danimolsen1988/wifa_lock/README.md

# WiFa_Lock
The wifa_lock is an IoT device capable of opening a lock, using facial recognition.
The development of this device has been a part of a course at Aarhus University.
The participants are on the 5th semester of the Electronics engineering branch.

# Contributors
- Jakob Aaboe Vestergaard
- Nikolaj Just Morsing
- Dani Mølgaard Olsen

# How to
- The report can be found in "Report"-folder

- The source code can be found in "SourceCode"-folder

- Models and figures made during development, can be found in "Model_and_figures"-folder

- The artefacts created during the development, can be found in "Artefacts"-folder

- All the extras can be found in the "Appendix"-folder

- All the datasheets for components used in this project can be found in the "Datasheets"-folder

To get started - see the verification section for prerequisites!

## Rich picture
The rich picture is an early system overview.  
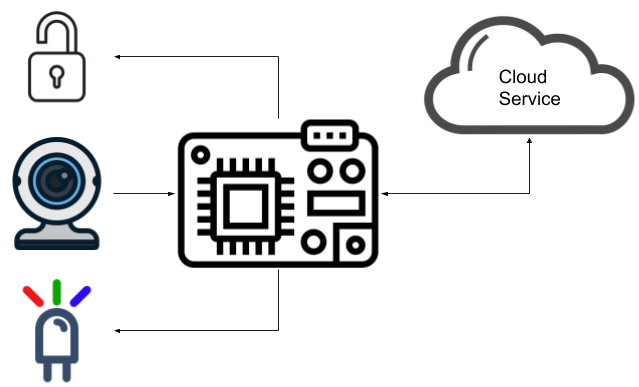
[picture p1: Models_and_figures/RichPicture.png]
GitHub Logo


## Prototype
### Main module
<p align="center">  
  
</p>

### Camera module

<p align="center">  
  
</p>
