danimolsen1988/wifa_lock/Appendix/Schematic_Simulering_RC-differentiator.pdf

## RC-differentiator design og simulering

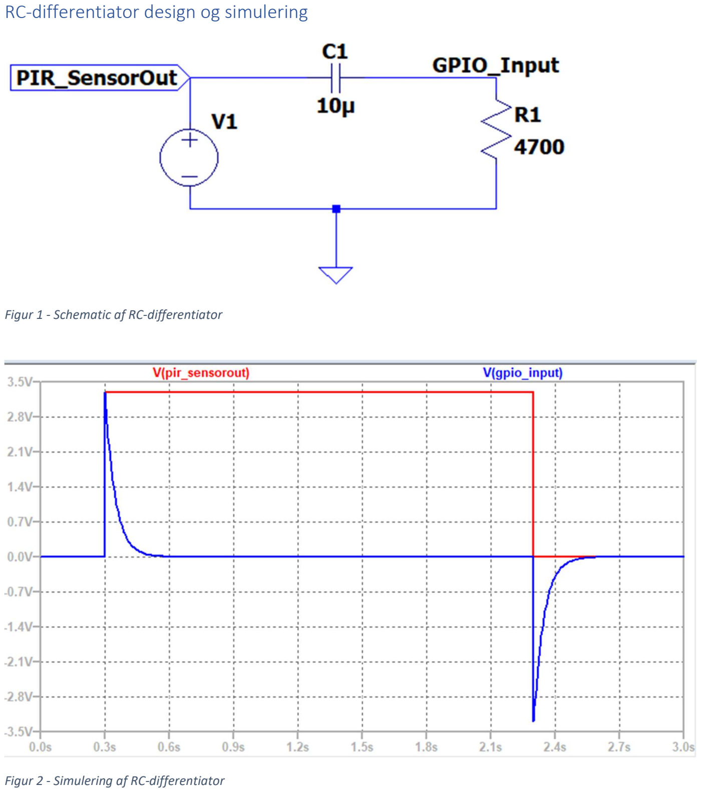
[picture p25: page 1]

Figur 1 - Schematic af RC-differentiator

Figur 2 - Simulering af RC-differentiator
