danimolsen1988/wifa_lock/Appendix/RC_og_Formodstand_udregninger.pdf

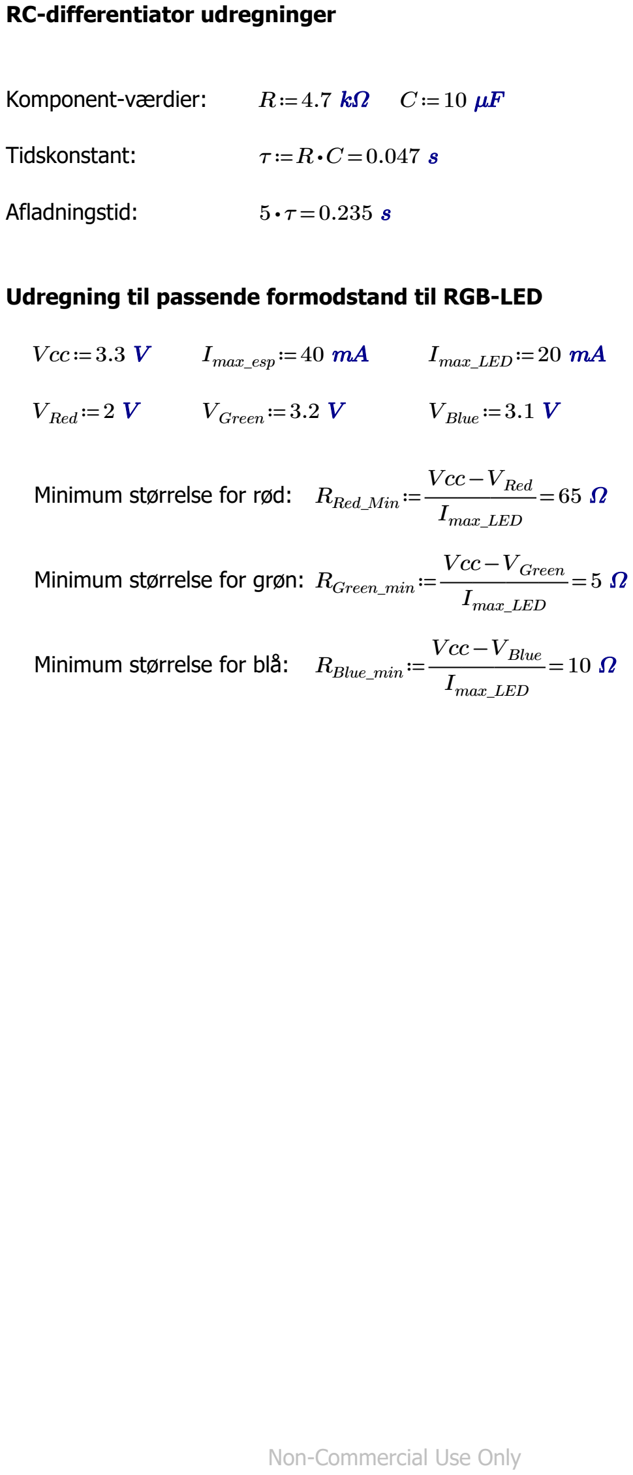
[picture p26: page 1]

RC-differentiator udregninger

Komponent-værdier: | R≔4.7 kΩ C≔10 μF
Tidskonstant: | τ≔R⋅C=0.047 s
Afladningstid: | 5 ⋅τ=0.235 s

Udregning til passende formodstand til RGB-LED

Vcc≔3.3 V | Imax_esp≔40 mA | Imax_LED≔20 mA
VRed≔2 V | VGreen≔3.2 V | VBlue≔3.1 V

Minimum størrelse for rød: RRed_Min≔――――=

| | Vcc-VRed Imax_LED 65 Ω

Minimum størrelse for grøn: RGreen_min≔――――=

| | Vcc-VGreen Imax_LED 5 Ω

Minimum størrelse for blå: RBlue_min≔――――=

| | Vcc-VBlue Imax_LED 10 Ω

Non-Commercial Use Only
