danimolsen1988/wifa_lock/Appendix/Hovedmodul_bilag.pdf

Hovedmodul
Her findes en mere dybdegående analyse af design af hovedmodelet
Hovedmodulets primære opgaver er at låse op for brugeren, hvis brugeren er i systemet. Derudover fungerer hovedmodulet som gateway imellem kameramodulet og Azure facial recognition service. På Figur 1 kan flowet af systemet ses.

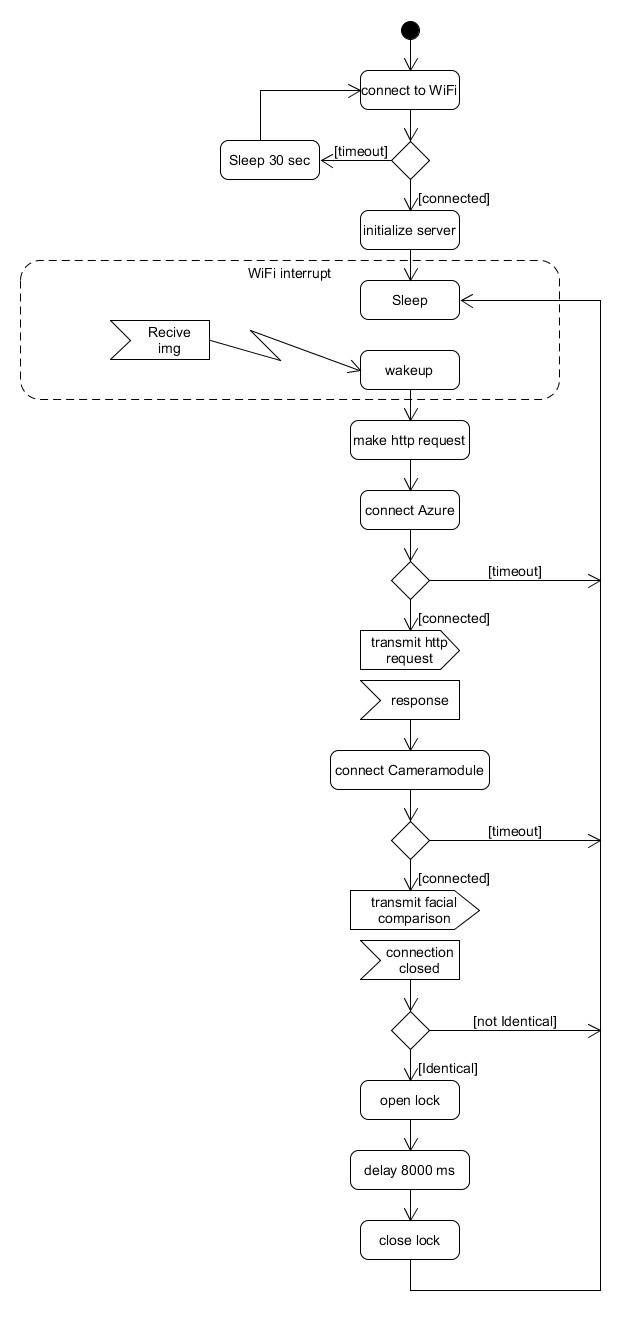
[picture p27: figure]

Figur 1 - aktivitetsdiagram over Hovedmodul

Figur 2 viser sekvensen over setup funktionen i arduio sketch filen. Denne funktion kører 1 gang som indledende setup, hvorefter funktionen loop sekventielt eksekveres i et loop. Sekvensdiagrammet for loop funktionen kan ses på Figur 3½

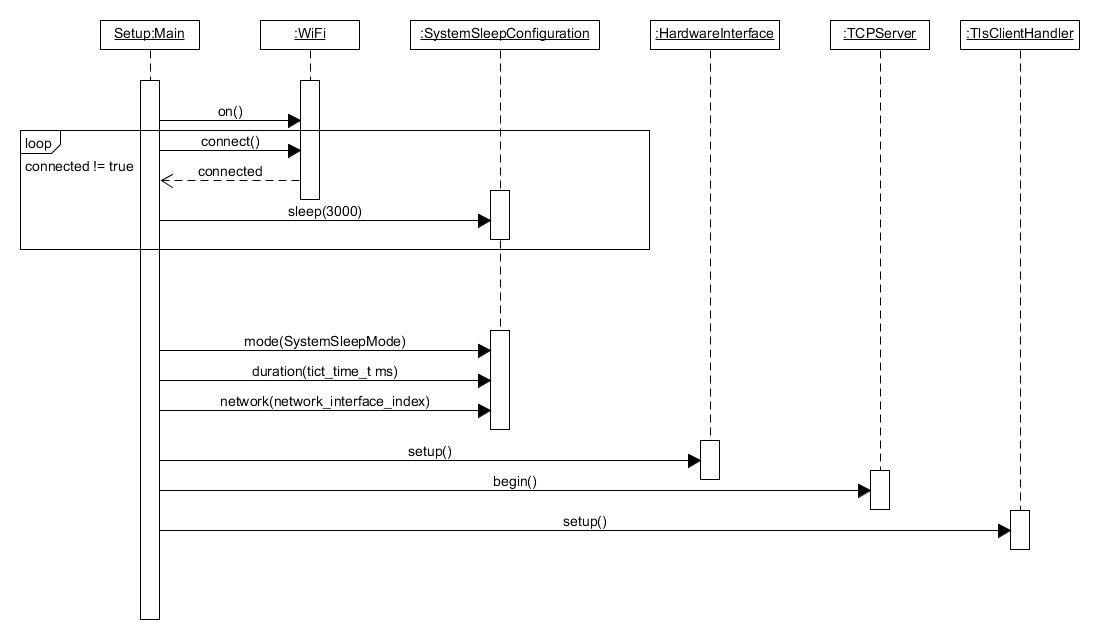
[picture p28: figure]

Figur 2 - sekvens diagram over setup i arduino sketch

Loop funktionen står for at styre mainflowet af programmet. Her ventes der på forbindelse TCP serveren der blev opretter i setup loopet. Når kameramodulet opretter forbindelse, modtages et billede der sendes over til TlsClientHandler klassen. Afhænging af retur værdien fra kaldet, sendes et svar tilbage til kameramodulet, indeholdende om personen blev godkendt eller ej. Blev Personen godkendt vil Servomotoren åbne i 8 sekunder, hvorefter den lukkes og system går i sleep tilstand

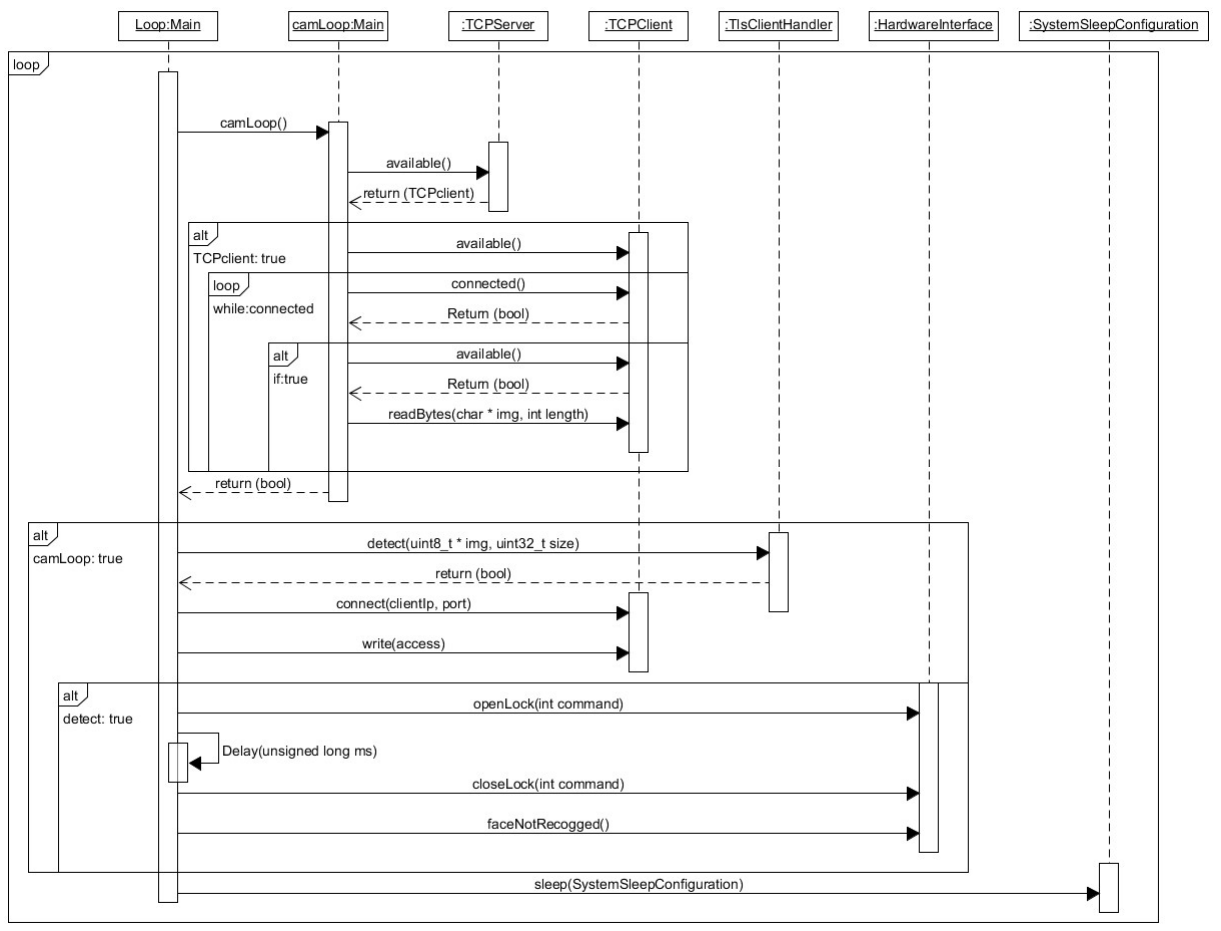
[picture p29: figure]

Figur 3 - sekvens diagram over loop i arduino sketch

Når detect bliver kaldt skal der forberedes til og sendes data til Azure, hvor der skal laves et http kald. Det er muligt og lave http kald vha. Particles cloud platform, men den understøtter ikke binary octet streams. Derfor er der designet en Httphelper klasse, der står for at parse http kald og svar. Forbindelsen til Azure oprettes via det eksterne bibliotek TlsTcpClient der er bygget op omkring mbedTLSOG Particles TCPClient. For at samle tls klienten med klassen HttpHelper er der designet en TlsClientHandler, der HttpHelper og kommunikationen imellem Azure.

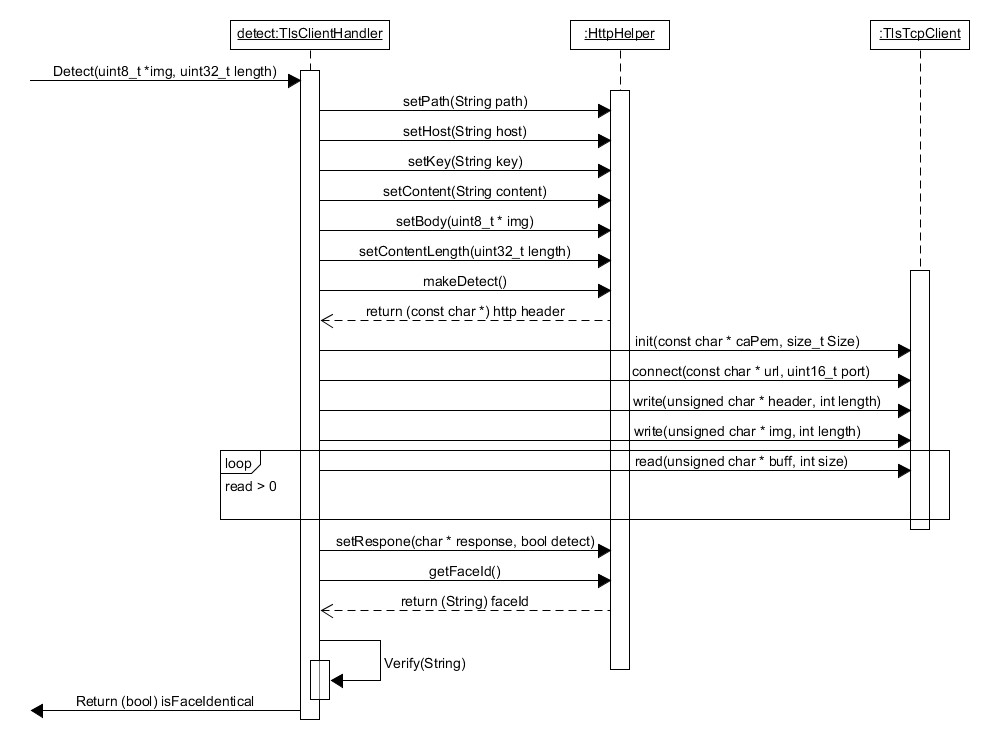
[picture p30: figure]

Figur 4 - sekvens diagram over detect
På Figur 4 kan det ses hvordan TlsClientHandler interagerer med de 2 klasser. For at sammenligne et ansigt skal Azure først detektere et ansigt, hvorefter der returneres et id. Dette id kan efterfølgende sendes til sammenligning med en person, allerede gemt i Azures database. Dette gøres med kaldet Verify, som kan ses på Figur 5.

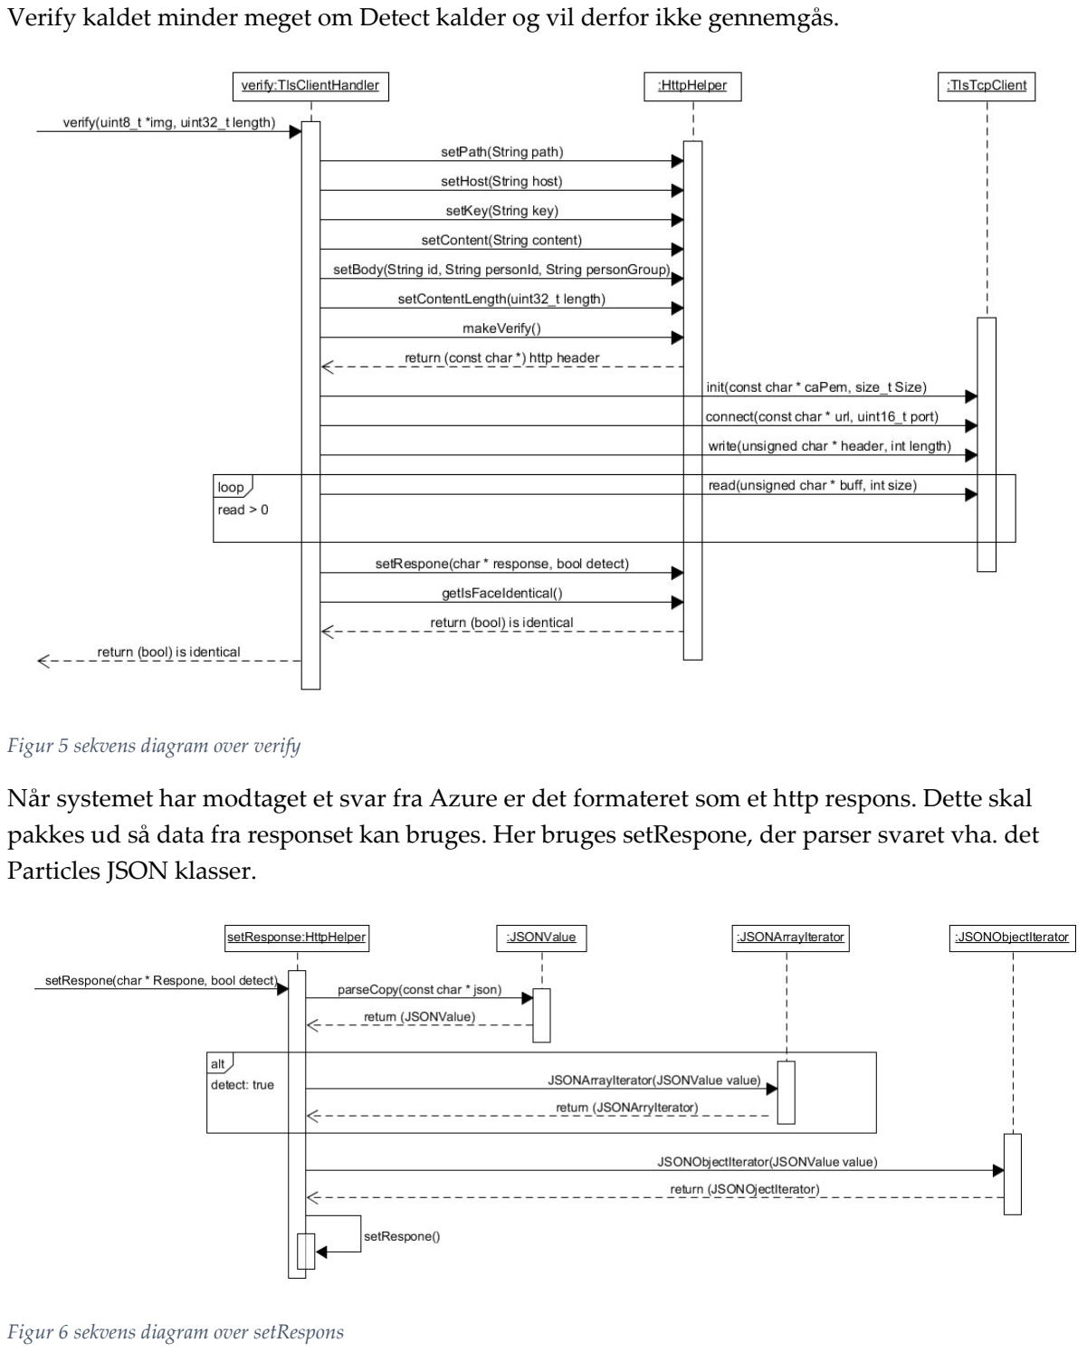
[picture p31: page 5]

Verify kaldet minder meget om Detect kalder og vil derfor ikke gennemgås.

Figur 5 sekvens diagram over verify
Når systemet har modtaget et svar fra Azure er det formateret som et http respons. Dette skal pakkes ud så data fra responset kan bruges. Her bruges setRespone, der parser svaret vha. det Particles JSON klasser.

Figur 6 sekvens diagram over setRespons

Dette giver nedenstående klassediagram.

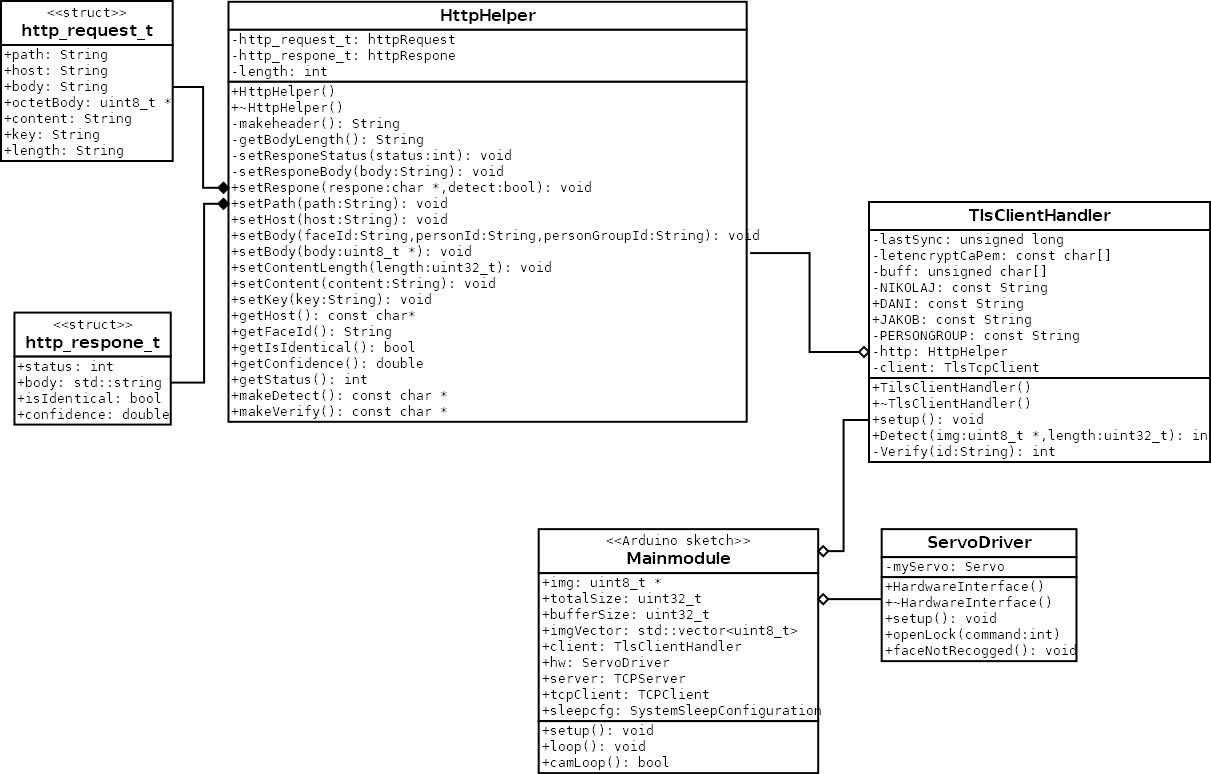
[picture p32: figure]

Figur 7 - klassediagram
