danimolsen1988/wifa_lock/Appendix/kameramodul_bilag.pdf

## Kamera modul

Sekvensdigram over kameramodul.

Digrammet har til hensigt at vise hvordan modulet går i sleep-tilstand og hvilke funktionskald der foretages for at tage et billede, samt notificere brugeren om hvilket stadie modulet befinder sig i.

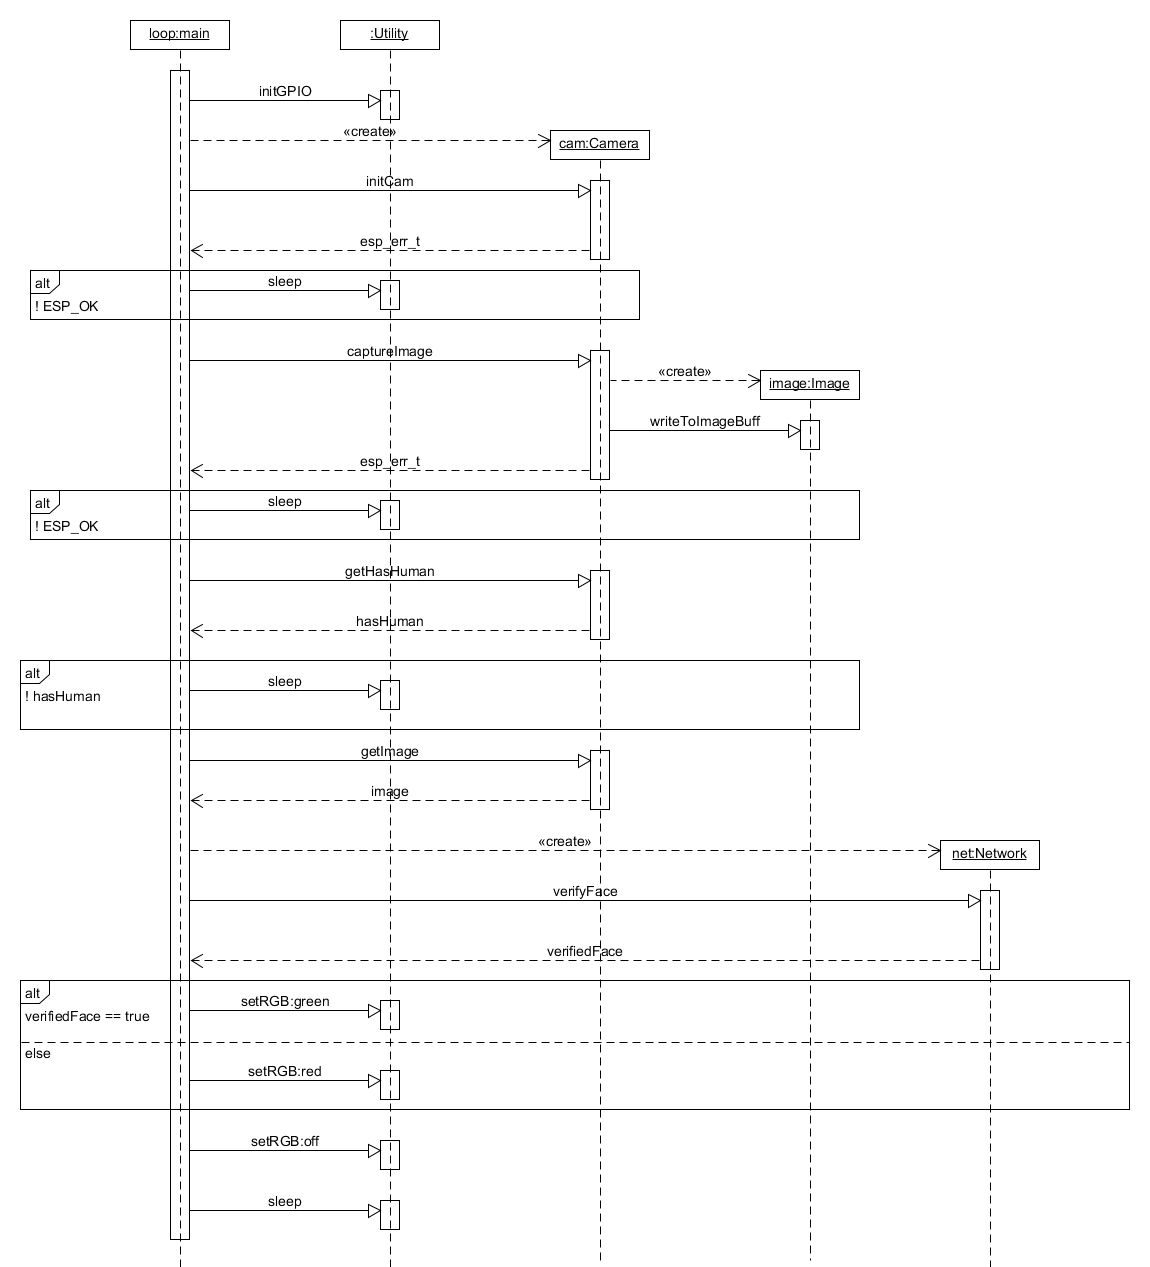
[picture p33: figure]
