danimolsen1988/wifa_lock/Appendix/Opsætning_af_Azure_&_reference_billede.pdf

## Opsætning af Azure facial service

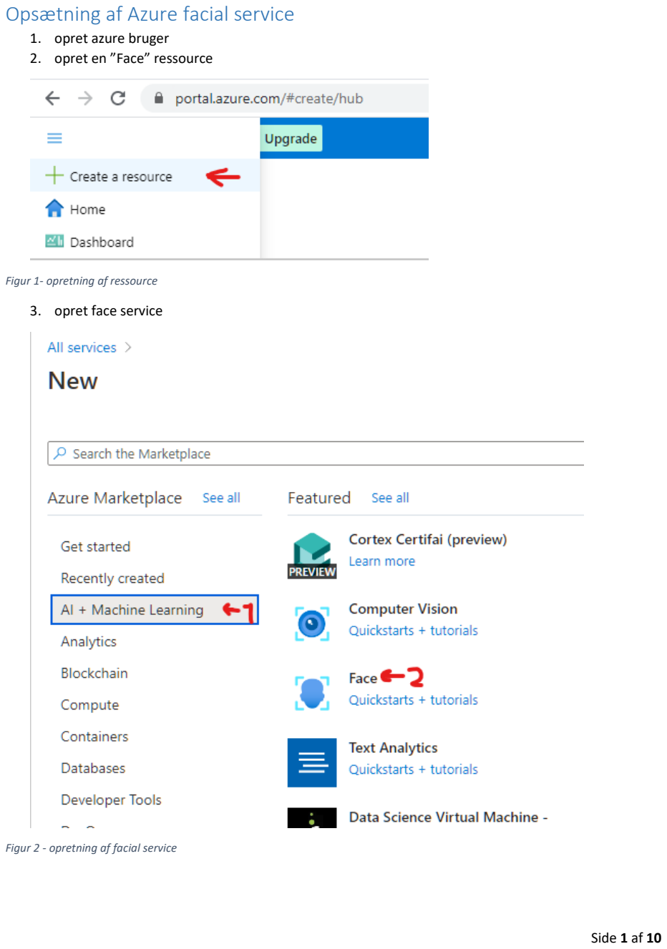
[picture p34: page 1]

Side 1 af 10

1. opret azure bruger
2. opret en ”Face” ressource

Figur 1- opretning af ressource

3. opret face service

Figur 2 - opretning af facial service

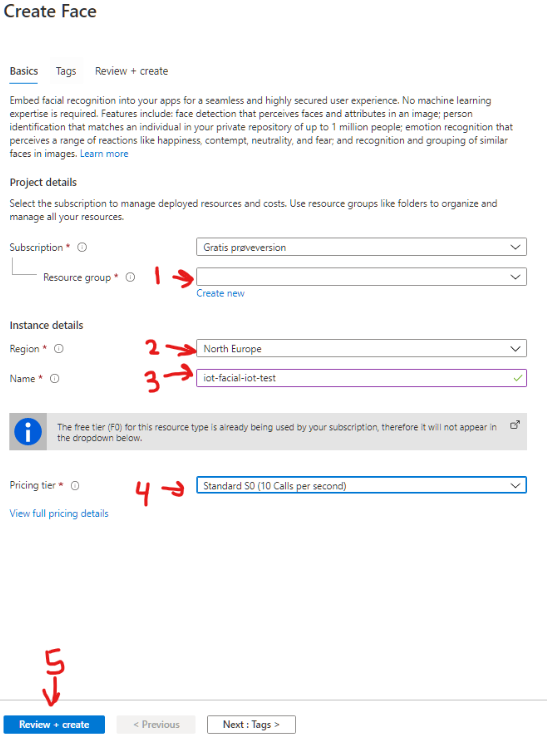
[picture p35: figure]

Side 2 af 10

Figur 3 - create facial service

Når dette er gjort, er det oprettet en facial service på azure cloud.

Efter dette navigerer over til home og vælg den nylig oprettet service.

## Tilføjelse af reference billede

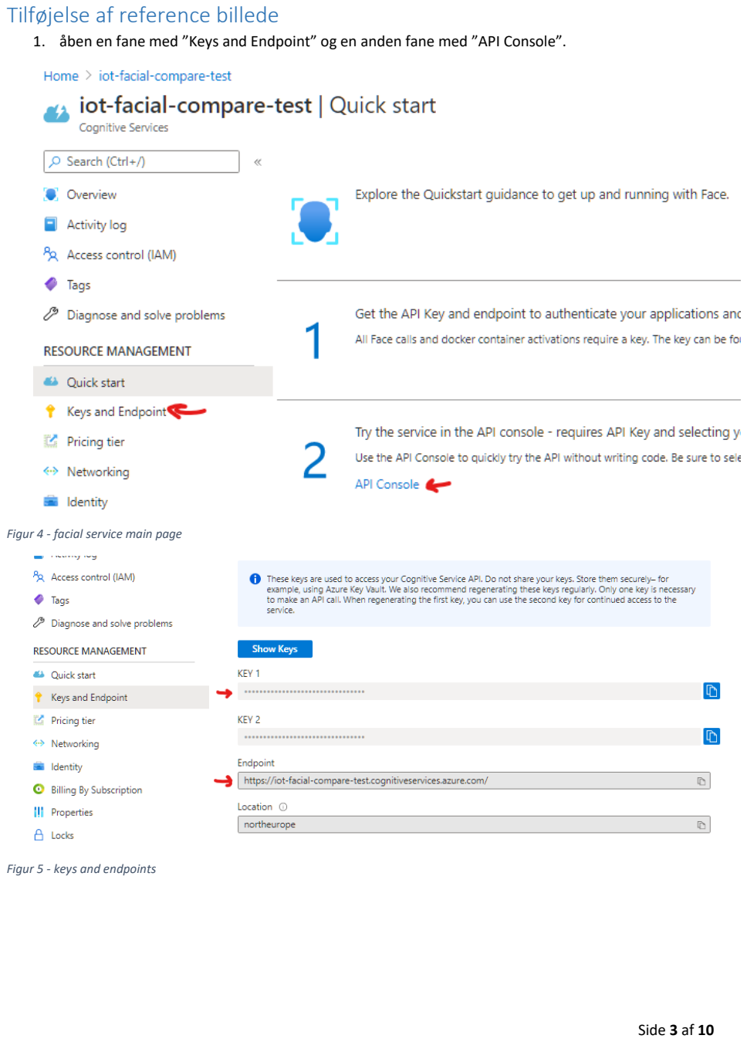
[picture p36: page 3]

Side 3 af 10

1. åben en fane med ”Keys and Endpoint” og en anden fane med ”API Console”.

Figur 4 - facial service main page

Figur 5 - keys and endpoints

Side 4 af 10

Inde under API, vælg PersonGroup og derefter Create. Vælg den location service er oprettet under, kan ses på Figur 5.

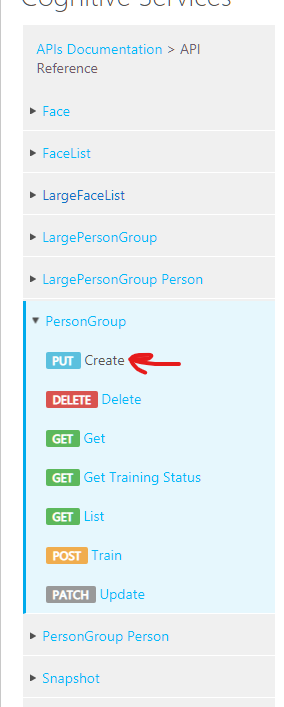
[picture p37: figure]

Figur 6- create PersonGroup

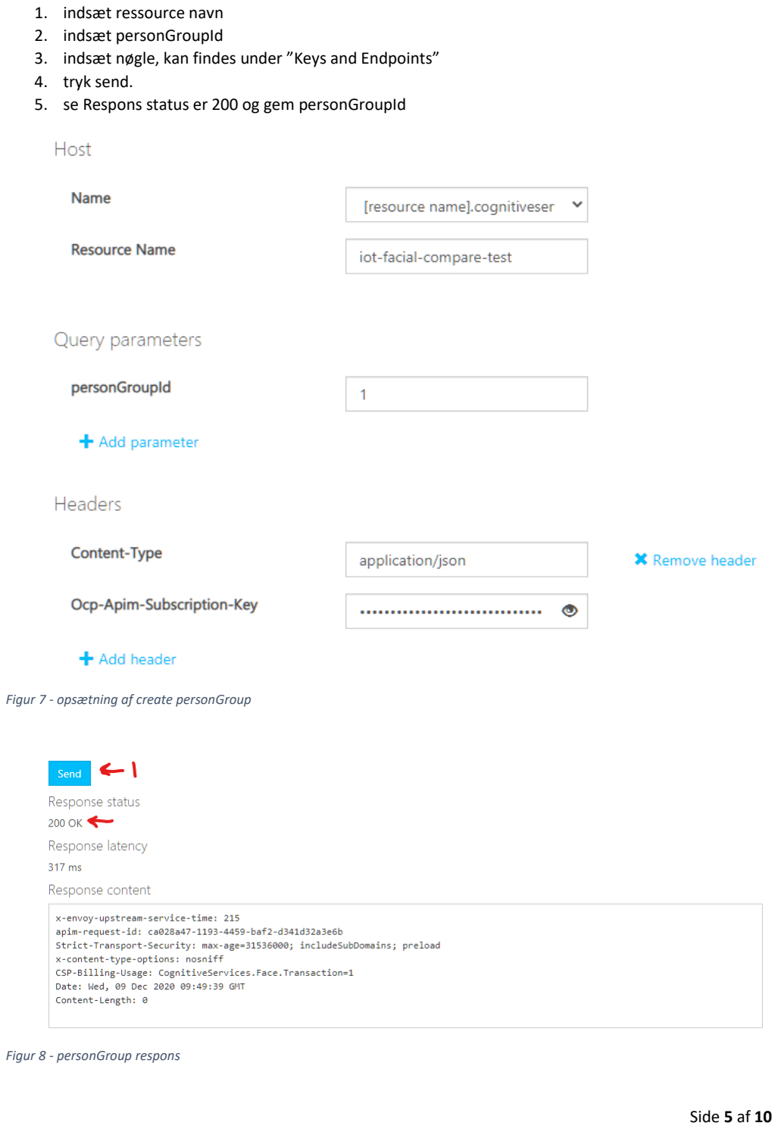
[picture p38: page 5]

Side 5 af 10

1. indsæt ressource navn
2. indsæt personGroupId
3. indsæt nøgle, kan findes under ”Keys and Endpoints”
4. tryk send.
5. se Respons status er 200 og gem personGroupId

Figur 7 - opsætning af create personGroup

Figur 8 - personGroup respons

Side 6 af 10

Efter der er lavet en PersonGroup kan der tilføjes en person til gruppen.

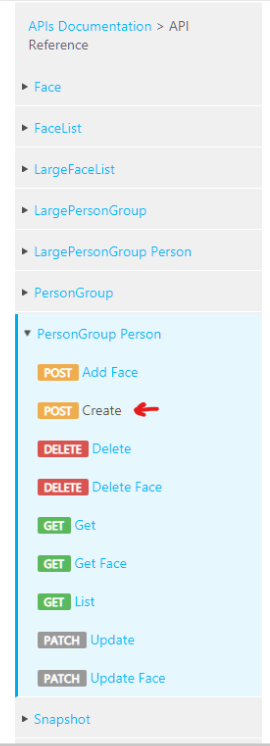
[picture p39: figure]

Figur 9 - Create personGroup Person

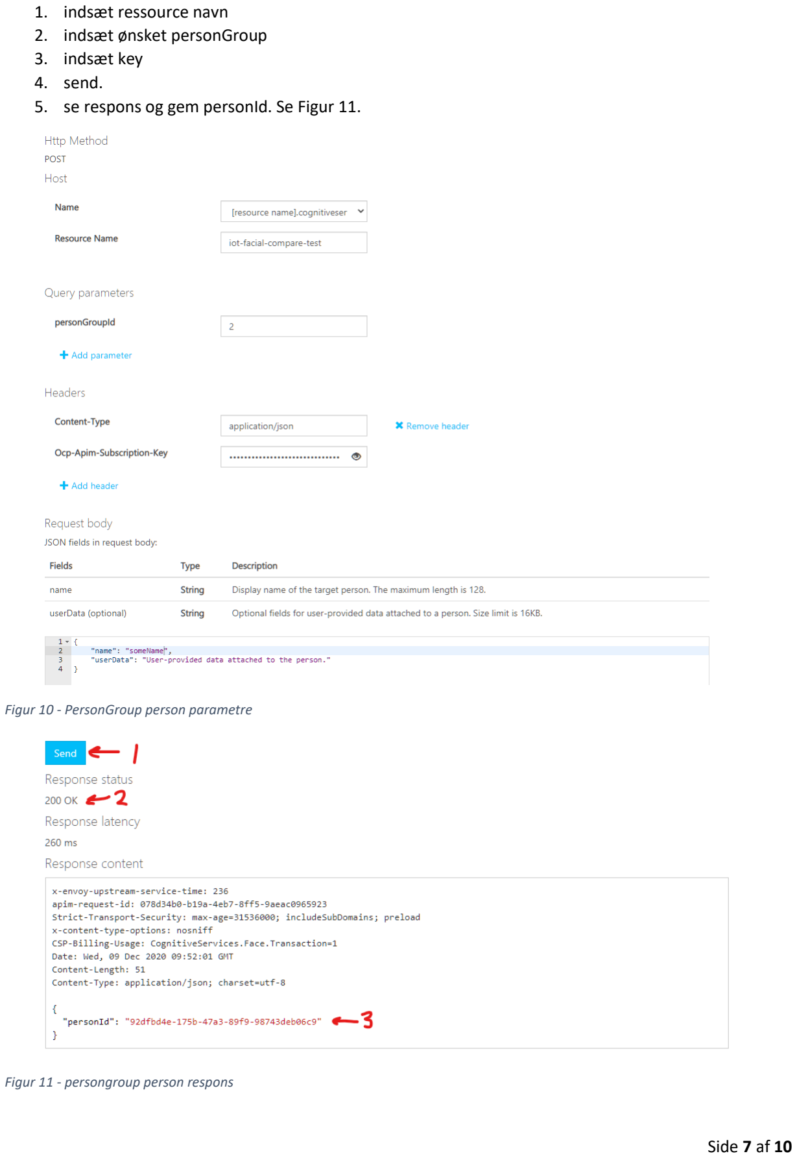
[picture p40: page 7]

Side 7 af 10

1. indsæt ressource navn
2. indsæt ønsket personGroup
3. indsæt key
4. send.
5. se respons og gem personId. Se Figur 11.

Figur 10 - PersonGroup person parametre

Figur 11 - persongroup person respons

Side 8 af 10

Når dette er gjort, kan der tilføjes et ansigt til personen.

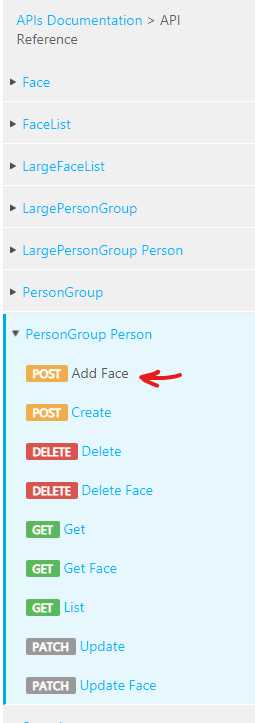
[picture p41: figure]

figur 12 - Add face to person

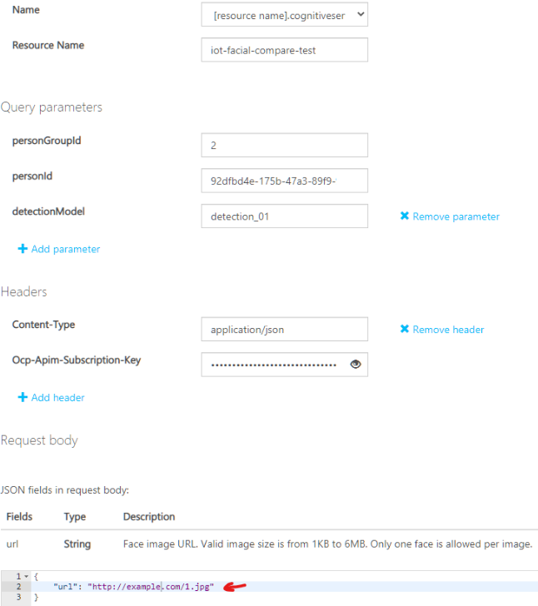
[picture p42: figure]

Side 9 af 10

1. indsæt ressource navn
2. indsæt personGroupId
3. indsæt Id på personen
4. indsæt nøgle
5. indsæt link til, det ønskede billede af ansigt.
6. tryk send.
7. se respons status er 200.

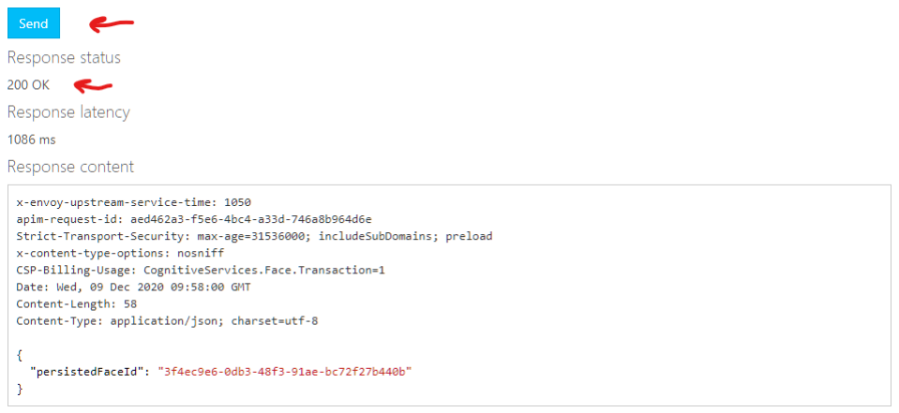
[picture p43: figure]

Side 10 af 10

Figur 13 - Add face to person parametre

Nu er der tilføjet et ansigt til en person, dette ansigt kan nu sammenlignes med.

For at sammenligne skal der bruges, GroupPersonId og PersonId
