danimolsen1988/wifa_lock/Models_and_figures/block_diagram.png

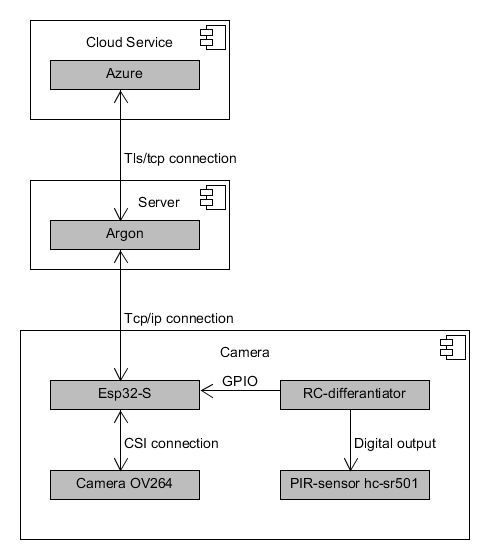
Models_and_figures/block_diagram.png
