danimolsen1988/wifa_lock/Models_and_figures/Cammodule figures/sqquence.png

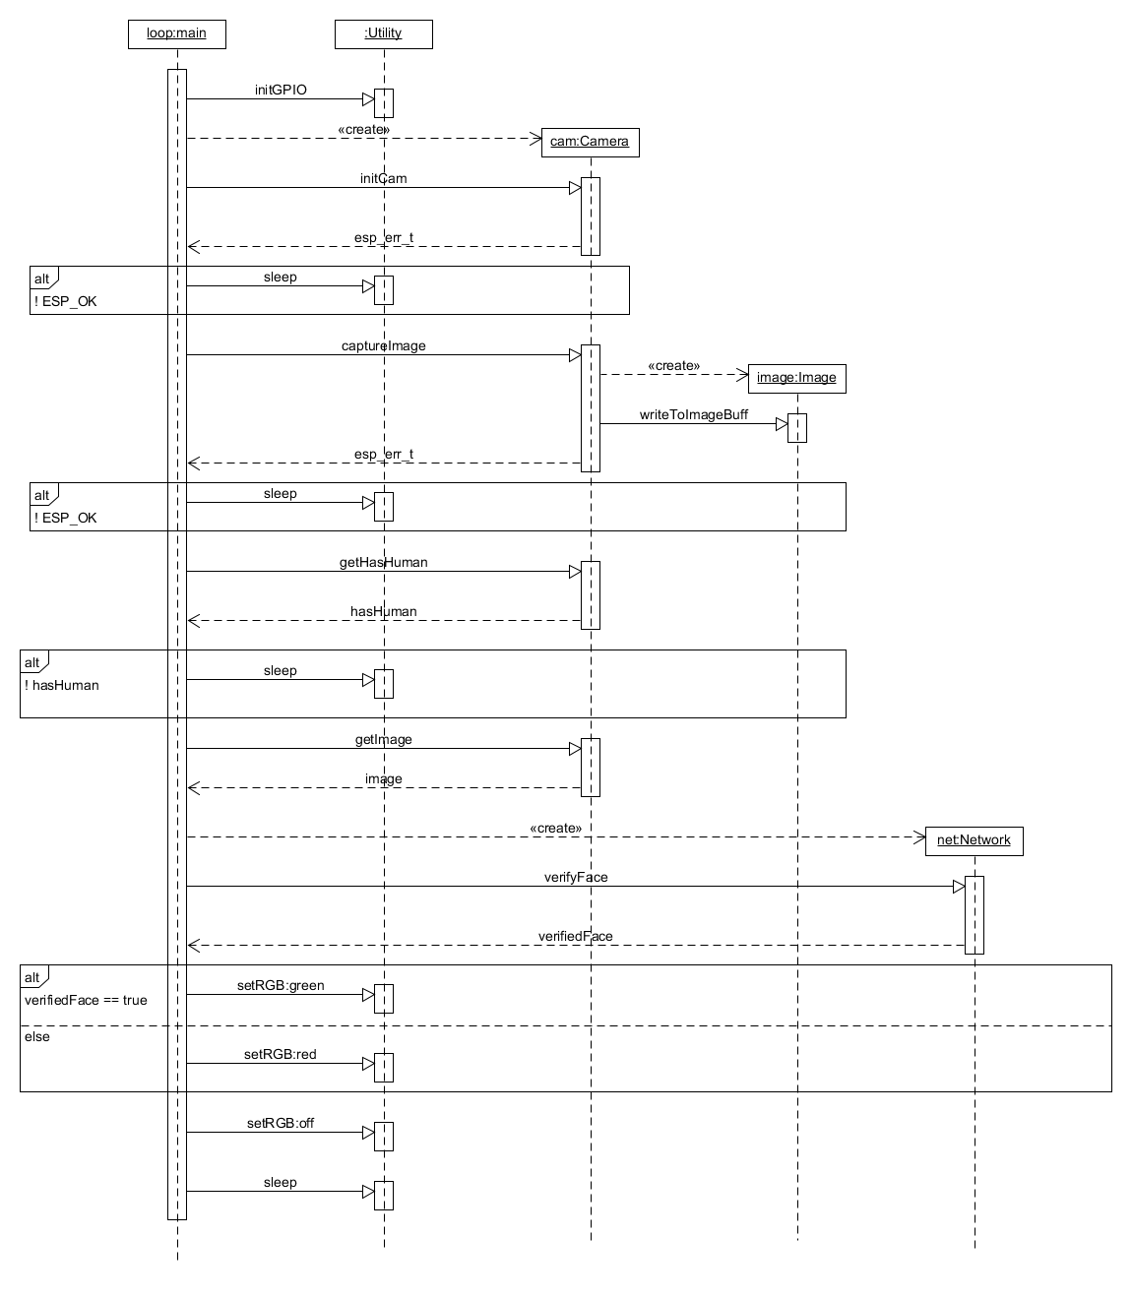
Models_and_figures/Cammodule figures/sqquence.png
