danimolsen1988/wifa_lock/Models_and_figures/Domain_model.png

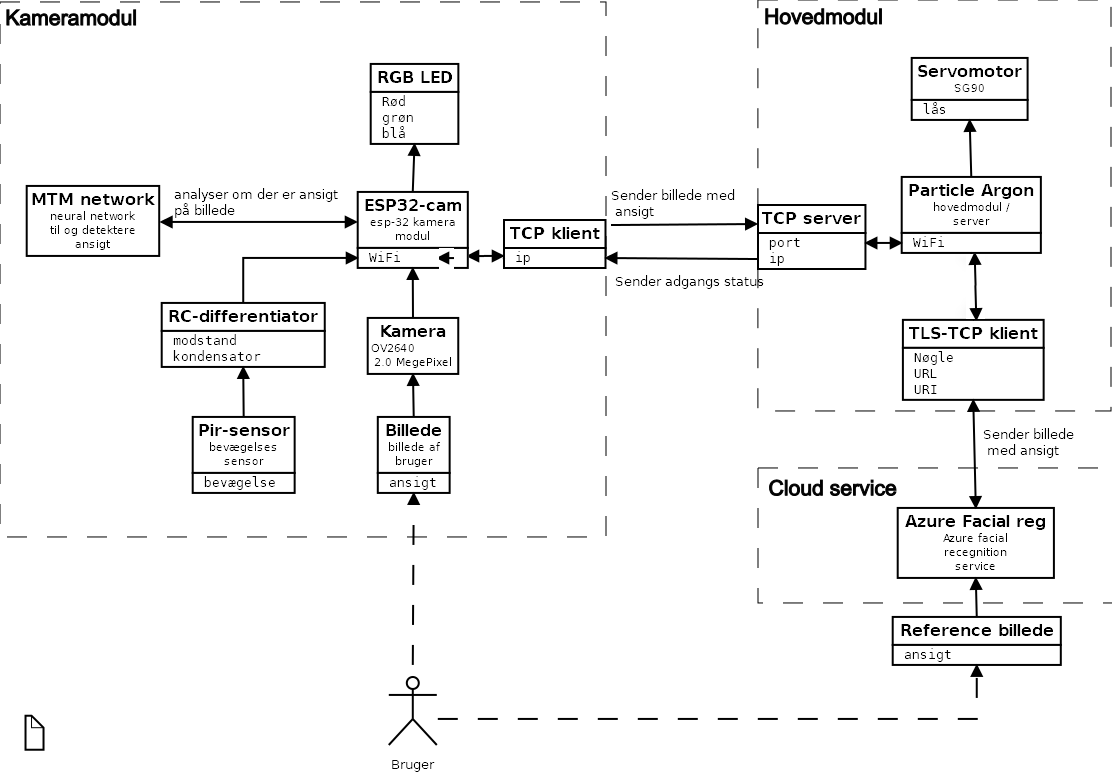
Models_and_figures/Domain_model.png
