danimolsen1988/wifa_lock/Models_and_figures/Mainmodule figures/Architecture_diagram_not_done.png

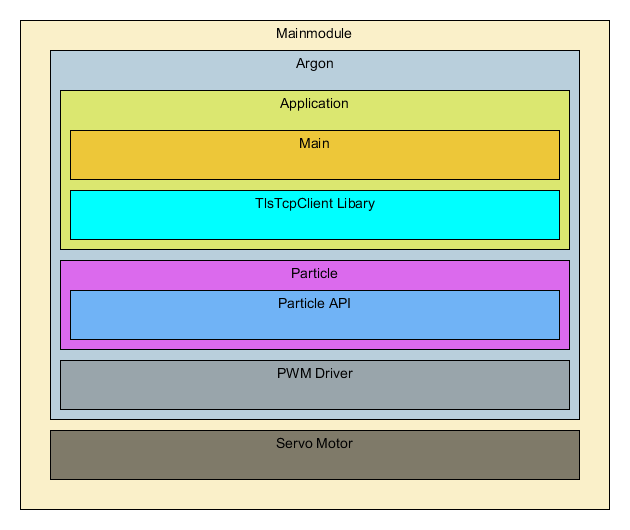
Models_and_figures/Mainmodule figures/Architecture_diagram_not_done.png
