danimolsen1988/wifa_lock/Models_and_figures/Mainmodule figures/argon_klassediagram_simplified.png

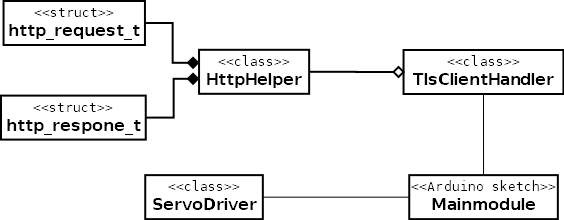
Models_and_figures/Mainmodule figures/argon_klassediagram_simplified.png
