danimolsen1988/wifa_lock/Models_and_figures/Mainmodule figures/meh_diagram.png

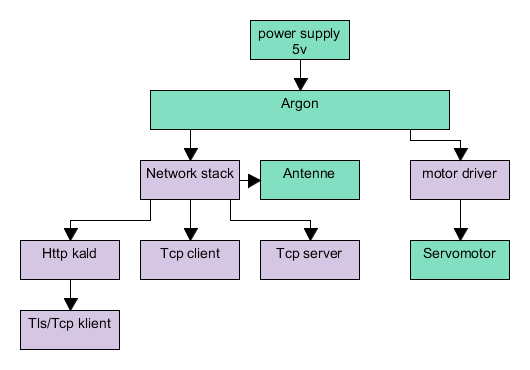
Models_and_figures/Mainmodule figures/meh_diagram.png
