danimolsen1988/wifa_lock/Models_and_figures/stateDiagram.png

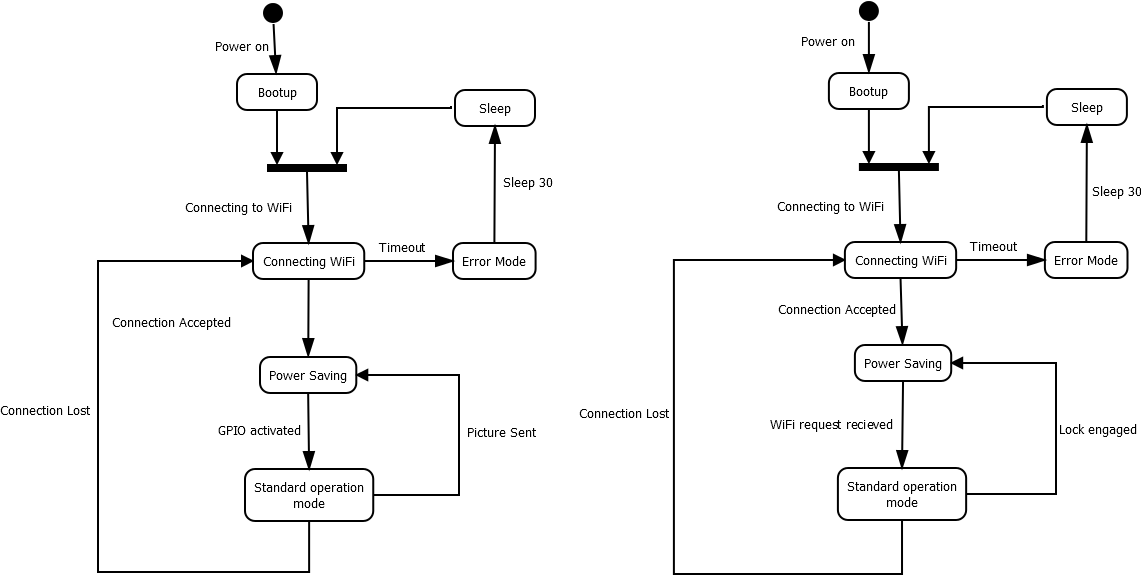
Models_and_figures/stateDiagram.png
