danimolsen1988/wifa_lock/Models_and_figures/Mainmodule figures/flow_makeHeader.png

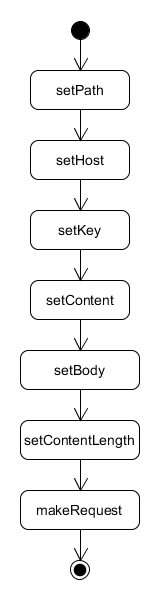
Models_and_figures/Mainmodule figures/flow_makeHeader.png
