danimolsen1988/wifa_lock/Appendix/Test&Verifikation_bilag.pdf

Side 1 af 12

## Test & Verifikation

I dette dokument findes hvordan kode hentes, opsættes, flashes og køres. Desuden er der en udførlig guide på hvordan de forskellige moduler skal opsættes for at udføre en test.

### Kameramodul

Forudgående betingelser
For at kunne udføre testen kræves følgende:
- Visual studio code installeret
- PlatformIO extension installeret
- TFDI board til flashing af kode til ESP32-CAM
- ESP32-CAM board
Test
- Pull kode fra git: wifa_lock/Cam/IOT-Cam at master · danimolsen1988/wifa_lock (github.com)
- Åben projekt i Visual studio
- Tilslut FTDI board til ESP32-CAM
o TX (FTDI) til GPIO3 (ESP32-CAM)
o RX (FTDI) til GPIO1 (ESP32-CAM) o GND (FTDI) til GND (ESP32-CAM)
- Tilslut HC-SR501 sensor til ESP32-CAM

o

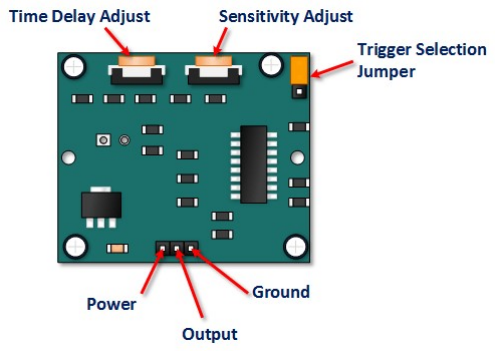
[picture p56: figure]

o Power (HC-SR501) til 5V,
o Ground (HC-SR501) til GND
o Output (HC-SR501) til GPIO13 (ESP32-CAM)
- Opsætning af WiFi
o Åben filen Network.cpp (Visual studio code)
- Ændre ssid til netværk modulet skal tilslutte
- Ændre pass til netværk modulet skal tilslutte
- Ændre host*, dette er påkrævet for at kunne kommunikere med hovedmodul.
- Ip-adresse til hovedmodul
- Tilslut FTDI board til computer o USB kabel
- Tilslut forsyning til ESP32-CAM o Tilslut 5V

Side 2 af 12

o Tilslut GND
- Flash program til ESP32-CAM
o Forbind GPIO0 til GND (ESP32-CAM)
o Tryk på RST (ESP32-CAM)
o Tryk på knappen ”PlatformIO: Upload” (Visual studio code) o Frakobl GPIO0 fra GND Når flash er fuldendt (ESP32-CAM)
- Tilslut Serial Monitor
o Tryk på knappen ”PlatformIO: Serial Monitor
- Vælg Com port USB er tilsluttet

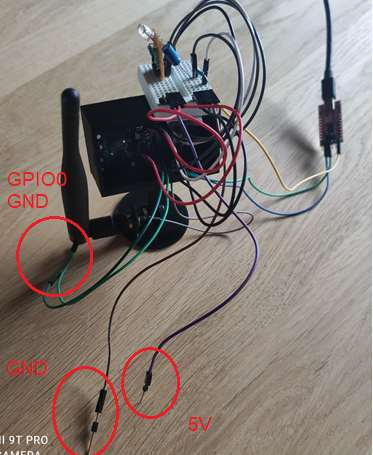
[picture p57: figure]

Side 3 af 12

### Hovedmodul

Forudsætninger:
- Visual studio installeret
- Particle workbench extension installeret I Visual studio
- Putty installeret
- Netværksforbindelse
Test
1. tilslut argon til usb.

### 2. hent kode fra https://github.com/danimolsen1988/wifa_lock/tree/master/ArgonTLS 3. åben projekt i visual studio 4. gå ind under debug.h 5. sæt DEBUG_AZURE ==1 6. tilføj filen codes.h som kan findes under bilag [REF]

a. flyt filen fra Bilag\code\codes.h over er i src\ i projekt folderen

### 7. byg program 8. flash system 9. start 10. tilslut argon serielt via Putty

a. serial
b. COM porten Argon er tilsluttet
c. Speed: 115200

Side 4 af 12

Test [1]
Følgende krav er testet i følgende test.
- Hovedmodulet skal aktiveres vha. netværkskommunikation Forudsætninger:
- ip-adresse af Argon
Test

### 1. setup Hovedmodul [Hovedmodul], i punkt 5, set i stedet DEBUG_AZURE == 0

2. se at Argon er gået i sleep mode. LED slukket.

### 3. åben cmd 4. skriv ”ping xxx.xxx.x.xx” 5. se argon svarer på ping

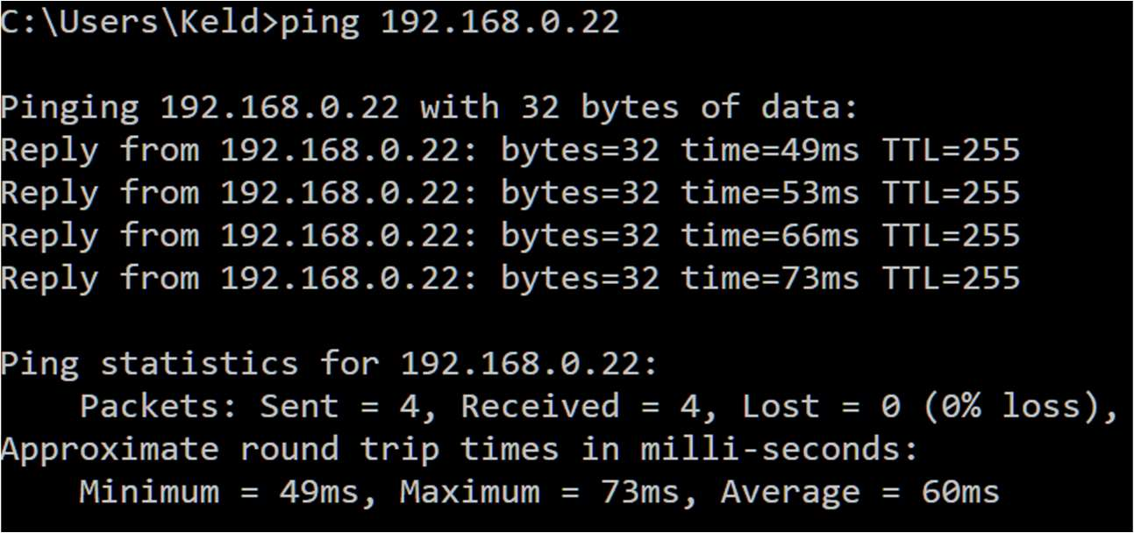
[picture p58: figure]

Figur 1- ping svar fra argon

Side 5 af 12

Test [2]
Følgende krav er testet i følgende test.
- Kameramodulet skal sende billeder til hovedmodulet
- Moduler skal kommunikere sammen vha. WiFi/bluetooth Test.

### 1. setup af Kameramodul[Kameramodul] 2. setup af Hovedmodul[Hovedmodul] 3. placer ansigt ~80 cm. foran kamera og vent på billede er taget

4. se i terminal for Argon, at der skrives ”client connected!” og en størrelse ud på billedet.
a. Er størrelsen over 2500, kan det forventes der er modtaget et billede. Og kravet ”Kameramodulet skal sende billeder til hovedmodulet” godkendt.
b. Er der sendt et billede over wifi kan kravet ”Modulet skal kommunikere sammen vha. WiFI/bluetooth” ligeledes godkendt

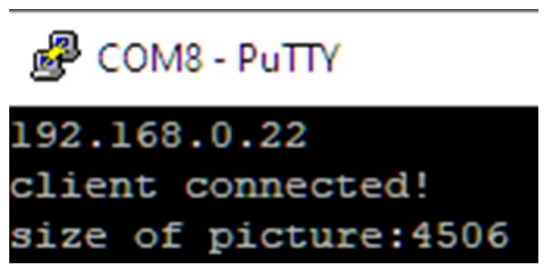
[picture p59: figure]

Figur 2 - argon output

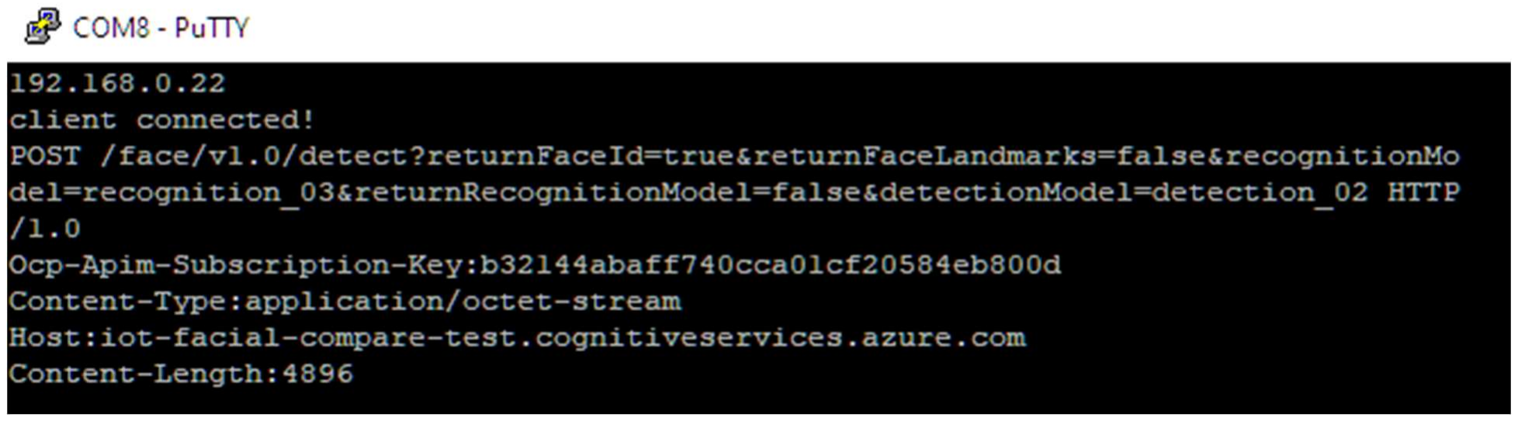
[picture p60: figure]

Side 6 af 12

Test [3]
Følgende krav er testet i følgende test.
- Når hovedmodulet modtager et billede fra kameramodulet, skal billedet sendes til (Online facial recognition service) og verificeres op mod reference billeder, hvis billedet matcher et referencebillede, skal låsen låses op.
- Når et billede afvises, skal LED lyse rødt.
- Når objektgenkendelse identificerer en person, sendes billede til hovedmodul.
- Hovedmodulet skal være forbundet til internettet vha. WiFi
- Mens lås er låst op, skal LED på kameramodulet lyse grønt
- Mens kameramodulet afventer verifikation, skal LED lyse blå.
Test.
Forudsætninger:
- 2 personer, 1 der er godkendt og en der ikke er godkendt adgang.
1. setup af Kameramodul[Kameramodul].
2. setup af Hovedmodul[Hovedmodul].
3. placer ansigt ~80 cm. foran kamera og vent på billede er taget.
4. se på Argon terminal der skrives ”client connected!”.

### 5. se på Kameramodulet rgb led lyser blåt

a. hvis led lyser blåt er kravet ”Mens kameramodulet afventer verifikatipn, skal LED lyse blå” godkendt.
6. se der sendes et http request, tjek at ”Content-Length:?” værdi er imellem 2500-8000, se Figur 3.

Figur 3 http request detect
7. se der kommer respons tilbage fra Azure med statusen 200 og et faceId, se Figur 4.
a. er der et faceId i responset er kravet ”Når objektgenendelse identificerer en person, sendes billede til hovedmodul” godkendt, da Azure har fundet et ansigt på billedet modtaget fra kameramodulet.
b. Kommer der respons er kravet ”Hovedmodulet skal være forbundet til internetter vha. WiFi” godkendt.

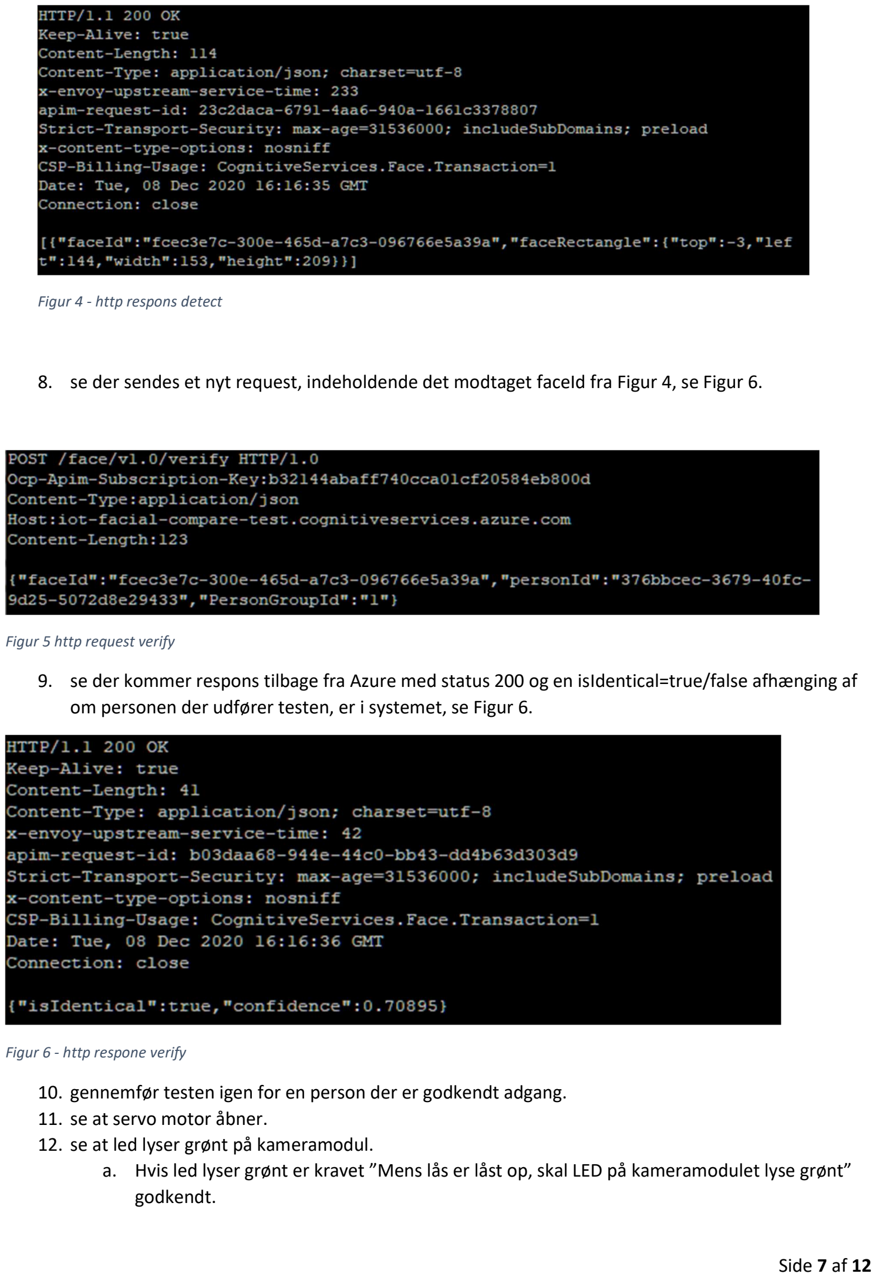
[picture p61: page 7]

Side 7 af 12

Figur 4 - http respons detect

8. se der sendes et nyt request, indeholdende det modtaget faceId fra Figur 4, se Figur 6.

Figur 5 http request verify
9. se der kommer respons tilbage fra Azure med status 200 og en isIdentical=true/false afhænging af om personen der udfører testen, er i systemet, se Figur 6.

Figur 6 - http respone verify
10. gennemfør testen igen for en person der er godkendt adgang.
11. se at servo motor åbner.
12. se at led lyser grønt på kameramodul.
a. Hvis led lyser grønt er kravet ”Mens lås er låst op, skal LED på kameramodulet lyse grønt” godkendt.

Side 8 af 12

13. se at servo motor lukker efter 8* sekunder.
14. gennemfør test igen for en person der ikke er godkendt adgang.
15. se at servo motor forbliver lukket.
16. se at led på kameramodul blinker rødt.
a. Blinker led rød er der nægtet adgang og derved er kravet ”når et billede afvises skal led lyse rødt” godkendt.

Side 9 af 12

Test [4]
Testen verificerer 2 krav på samme tid, kravene som udføres er:
- Når et menneske stiller sig foran, indenfor 2 meter af kameramodulet. Skal systemet tage et billede og foretage objektgenkendelse (Person)
- Kameramodulet skal implementeres som et edge device, hvor der udføreres ansigtsdetektering på billeder
Test

### 1. setup af Kameramodul [Kameramodul] 2. Placerer kameramodul sådan forsiden peger udad, i et rum med mere end 3 m. til væg

3. Placerer dig 3 meter fra fronten af kameramodulet.
4. Udfør bevægelse uden at komme tættere på kameramodulet.
a. Verificer at der ikke udføres en blitz
5. gå 1 meter imod kameramodul, sådan der er en afstand på 2 meter mellem din placering og kameramodulet.
a. Verificer at der udføres en blitz.
6. se på konsol om ansigt er detekteret.
a. Se Figur 7, for hvordan konsol information skal se ud.

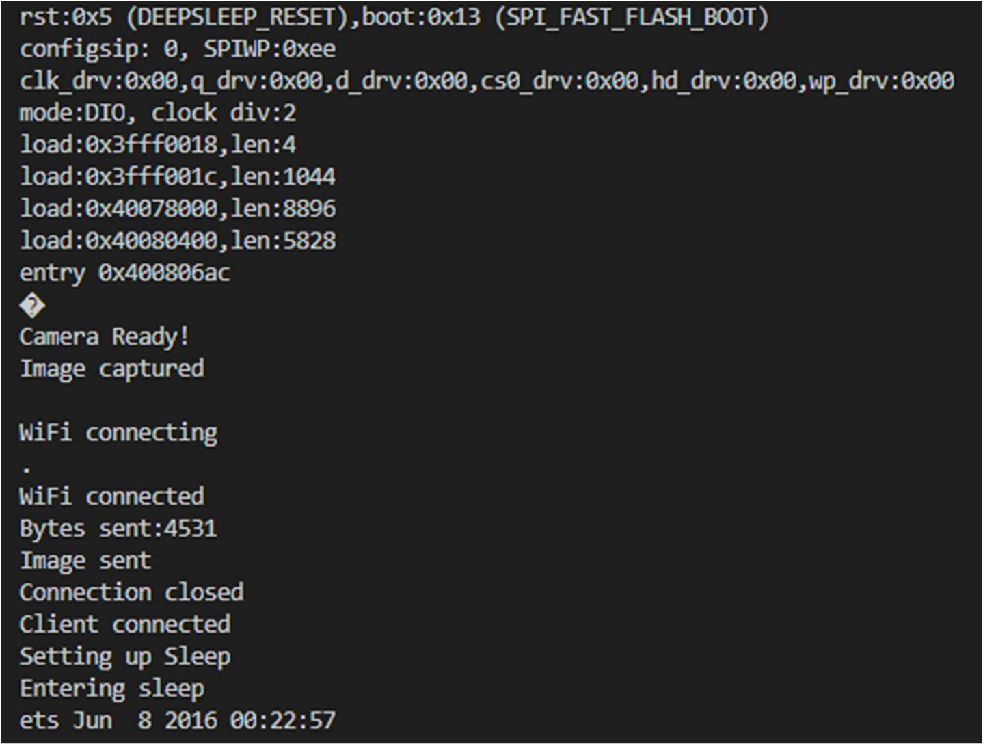
[picture p62: figure]

Figur 7 - Ansigt detekteret

### 7. Stil dig udenfor kameramodulet kameravinkel 8. Udfør bevægelse fora kameramodul med hånd

a. Hvis der detekteres en blitz, er der taget et billede

### 9. se på konsol om et ansigt er detekteret

a. se Figur 8, for hvordan konsol information skal se ud.

Side 10 af 12

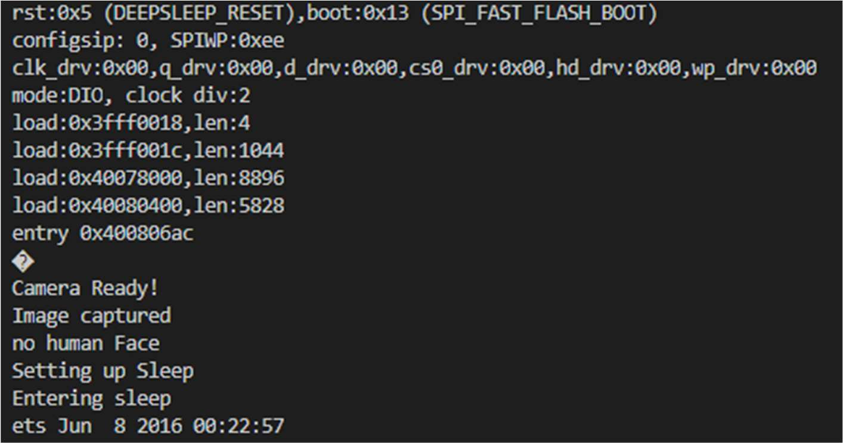
[picture p63: figure]

Figur 8 - Ansigt ikke detekteret

Test [5]
Testen verificerer to krav på samme tid, kravene er:
- Kameramodulet skal aktiveres vha. en sensor
- Mens kameramodulet er i power saving mode, skal systemet vågne op ved input fra digital indgang Test

### 1. setup af Kameramodul [Kameramodul] 2. Placerer kameramodul sådan forsiden peger udad, i et rum med mere end 3 m. til væg 3. verificer at sidste besked i konsollen er ”Entering Sleep”

a.
4. Placerer dig 1 meter fra fronten af kameramodulet.
5. Udfør bevægelse uden at komme tættere på kameramodulet.
a. Verificer at der kameramodulet blitzer

Side 11 af 12

Test [6]
Testen verificerer kravet:
- Hvis kameramodulet ikke kan forbinde til WiFi/bluetooth skal modulet gå i power saving mode. Test

### 1. setup af Kameramodul [Kameramodul]

2. Sluk access point, så kameramodul ikke kan forbinde til WiFi.

### 3. Placerer kameramodul sådan forsiden peger udad, i et rum med mere end 3 m. til væg

4. Placerer dig 1 meter fra fronten af kameramodulet.
5. Udfør bevægelse uden at komme tættere på kameramodulet.
a. Verificer at der udføres en blitz
b. verificer ansigt detekteres
6. se på konsol om modul går i sleep-tilstand.
a. Se Figur 9, for hvordan konsol information skal se ud.

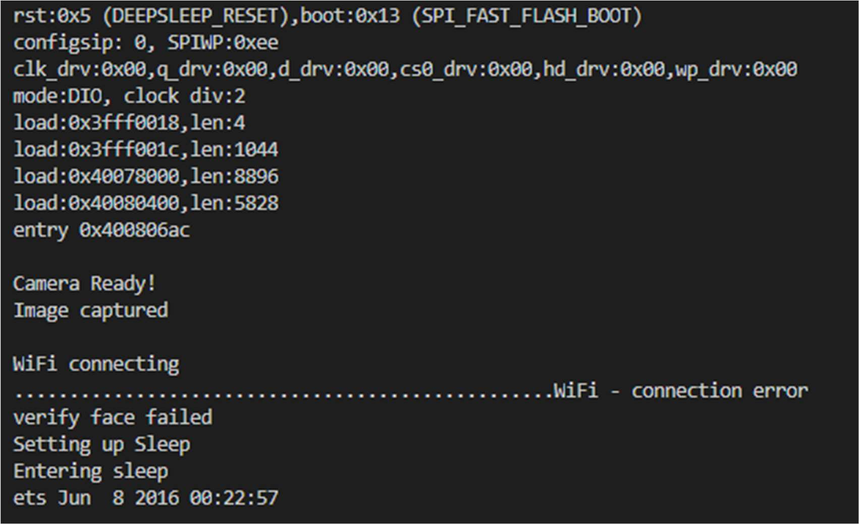
[picture p64: figure]

Figur 9 - WiFi connection error

Side 12 af 12

Test [7]
Testen verificerer kravet:
- Kameramodulet skal være low power og kunne holde strøm i op til 30 dage, ved normal brug

### 1. Download Otii Arc’s software og installer dette (https://www.qoitech.com/download/) 2. Tilslut Otii Arc til PC via USB og tilslut ekstern forsyning 3. Opsætning af Otii

- Indstil udgangsspændingen til 5V
- Indstil max current limit til det højest mulige

4. Tilstlut Otii Arc’s – til stel på ESP32-CAM 5. Tilslut Otii Arc’s + til forsyning af ESP32-CAM 6. Tryk på Record 7. Udfør samme steps som i Test 3 8. Stop record og notér AVG: Current 9. Start en ny måling og lad enheden være idle i minimum et minut 10. Stop record og notér AVG: Current 11. Udregn et samlet energiforbrug ud fra gennemsnitsstrømmen fra de to målinger
- Det antages at der er 6 aktiveringer pr dag i en periode på 30 dage
- Fremgangsmåden for udregningen kan ses i bilaget strømUdregninger&målinger_bilag.pdf

### 12. Verificer at den samlede mængde energi er ca. 4400mAh
