danimolsen1988/wifa_lock/Models_and_figures/Mainmodule figures/Sequence_Verify.png

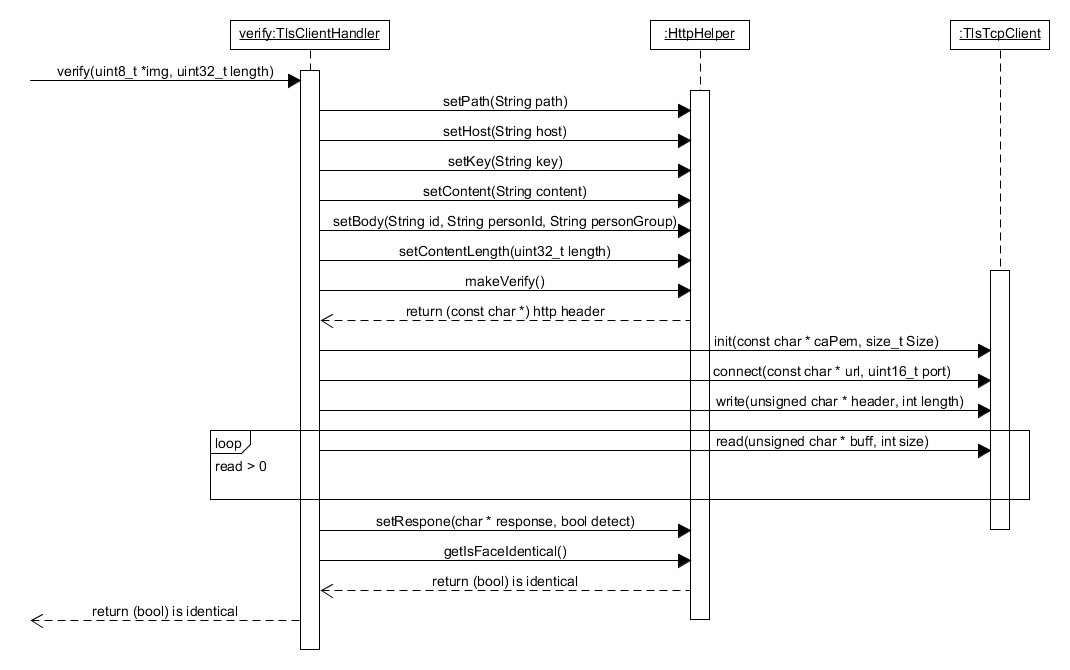
Models_and_figures/Mainmodule figures/Sequence_Verify.png
