danimolsen1988/wifa_lock/(commit log)

2020-10-22 sensor parametres
2020-11-11 deleted BLE as it won't work to out purpose
    [main.cpp]
2020-11-26 Cam - with sleep function - does not work
    [main.cpp]
2020-11-26 Revert "renamed stuff"
    This reverts commit 34f87daa9571bd2e43029e16c925c08de656b47f.
    [HttpHelper.cpp, HttpHelper.h, TlsClientHandler.cpp, TlsClientHandler.h]
2020-12-01 Create Server_RGB_Control.cpp
    Functions to control servo and rgb
